WisdomKasozi/project-apogee/build-photos/hardware-store-materials-and-paint.webp

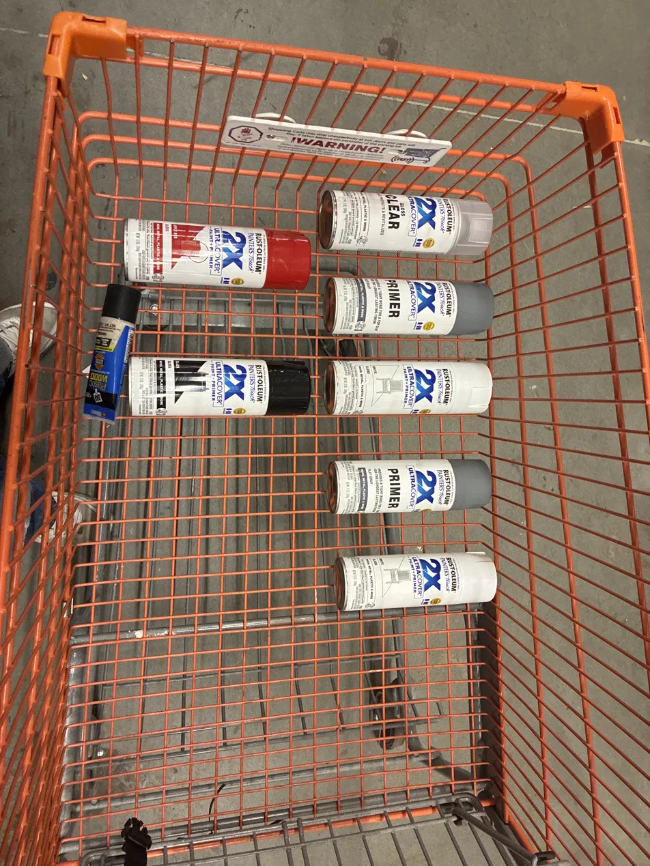
build-photos/hardware-store-materials-and-paint.webp
