WisdomKasozi/project-apogee/build-photos/balsa-fin-cutting-blueprint.webp

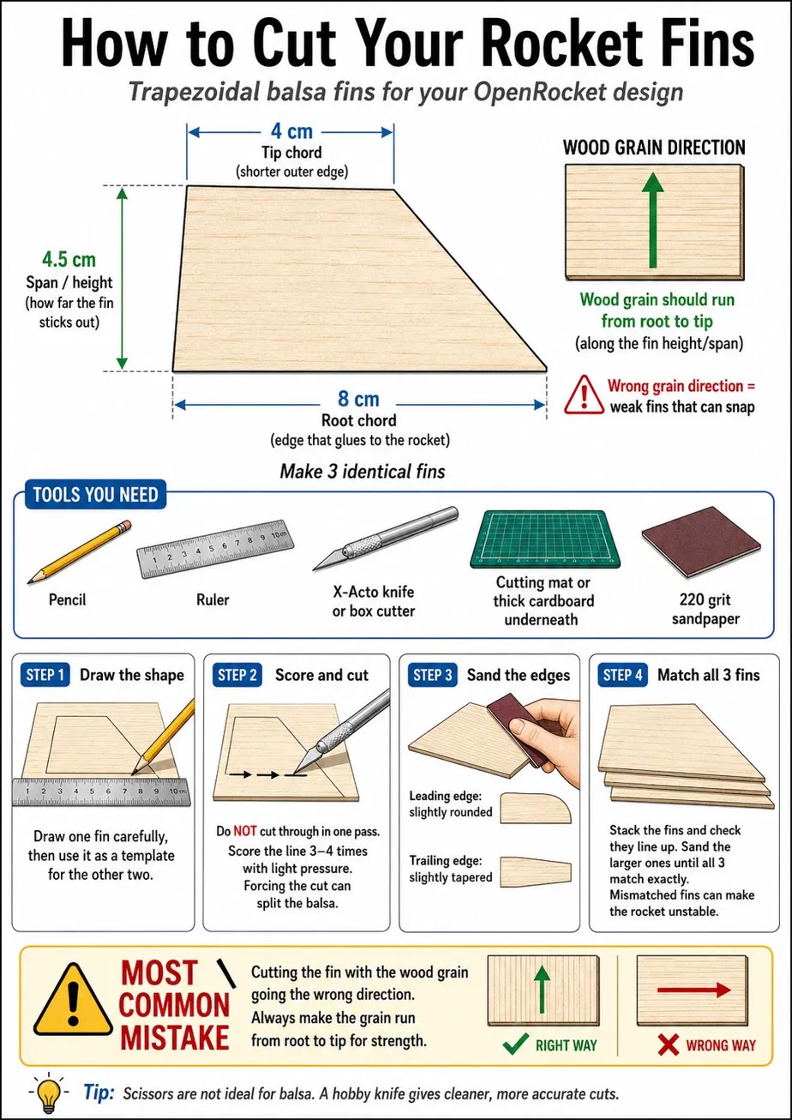
build-photos/balsa-fin-cutting-blueprint.webp
