WisdomKasozi/project-apogee/flight/graphs/graph1_altitude_profile.png

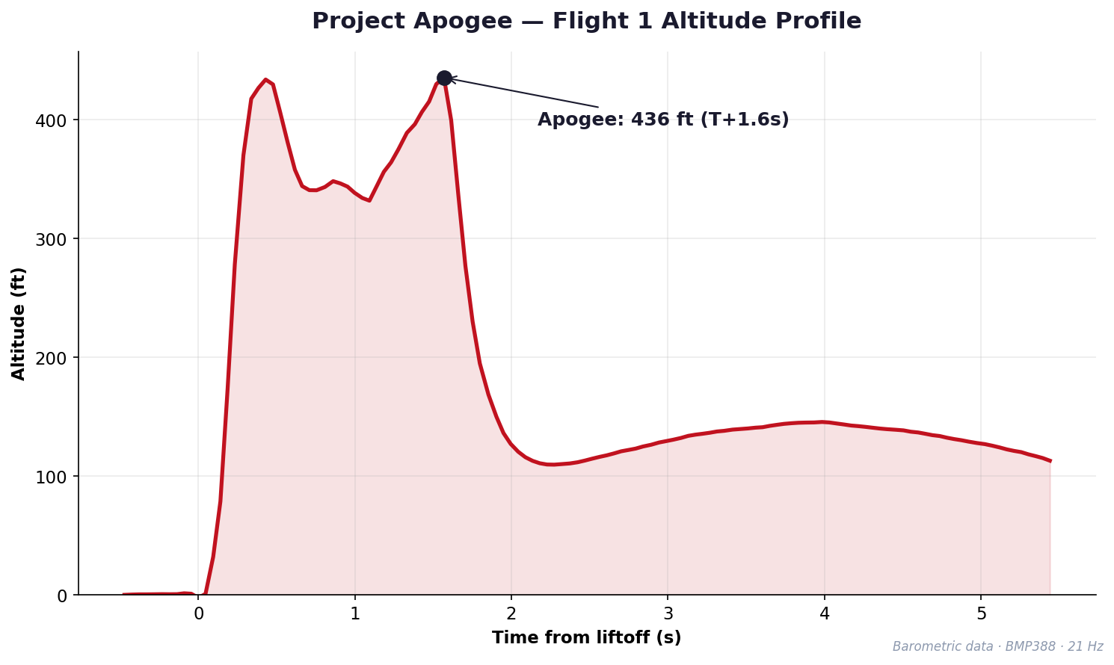
flight/graphs/graph1_altitude_profile.png
