WisdomKasozi/project-apogee/flight/graphs/graph2_acceleration_profile.png

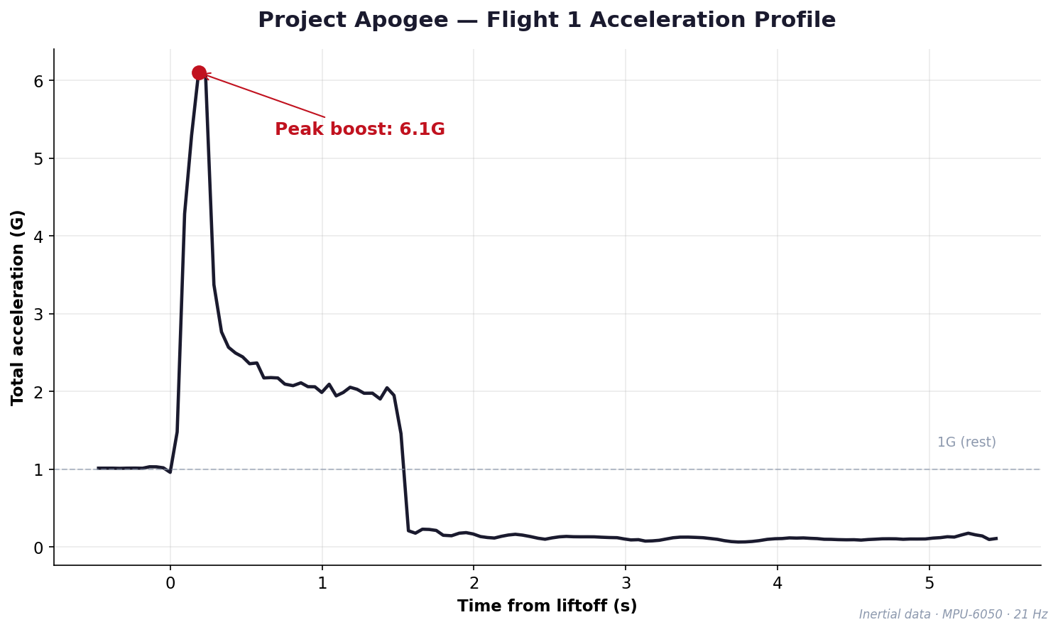
flight/graphs/graph2_acceleration_profile.png
