WisdomKasozi/project-apogee/flight/graphs/graph3_sim_vs_actual.png

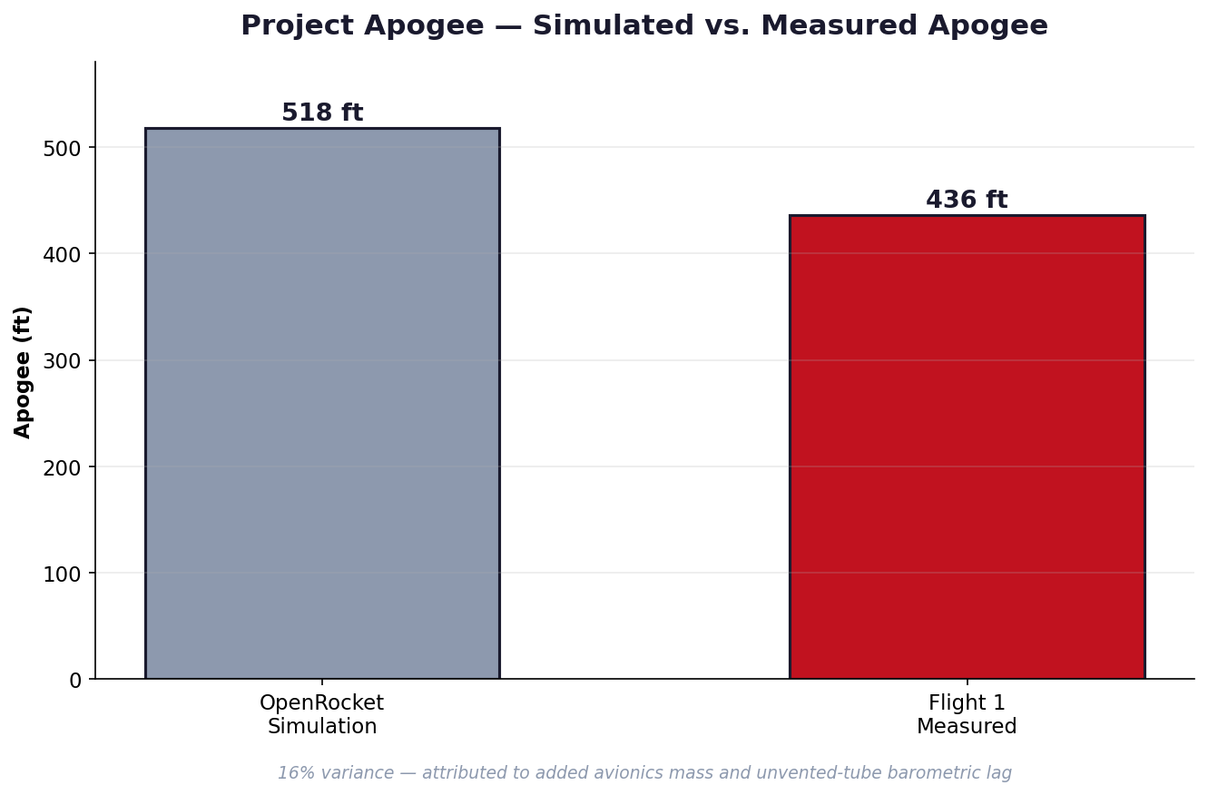
flight/graphs/graph3_sim_vs_actual.png
