WisdomKasozi/project-apogee/simulation/as-built/as-built-plot.png

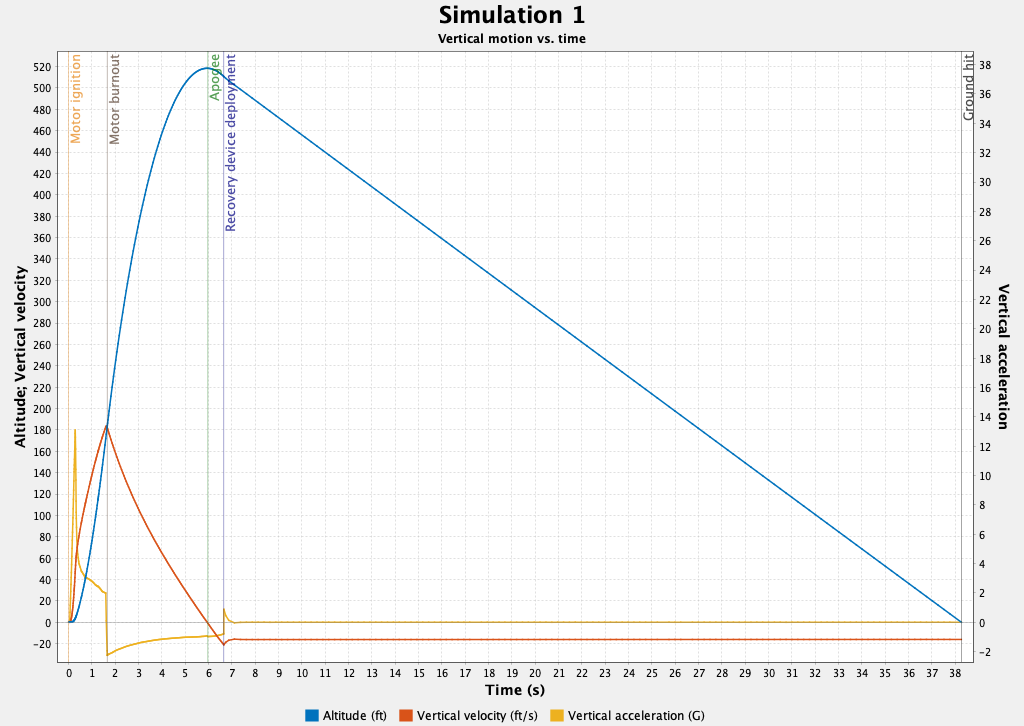
simulation/as-built/as-built-plot.png
