WisdomKasozi/project-apogee/simulation/pre-build/notes.md

## Pre-Build Simulation Notes

Date: May 2026

This simulation was completed before the parts arrived.
Dimensions are based on standard BT-60 specs and planned 
component dimensions. Weights are estimated.

### Key Results
- Stability margin: 1.64 calibers
- Apogee: 586 ft
- Velocity off rod: 61.4 ft/s (42 mph)
- Motor: Estes D12-5
- No warnings

### What changes in the built simulation
- Actual measured component weights
- Confirmed nose cone length
- Confirmed body tube cut lengths
- Electronics mass object added with real weight

## Simulation
OG sim
