WisdomKasozi/project-apogee/build-photos/assembled-airframe-and-nosecone.png

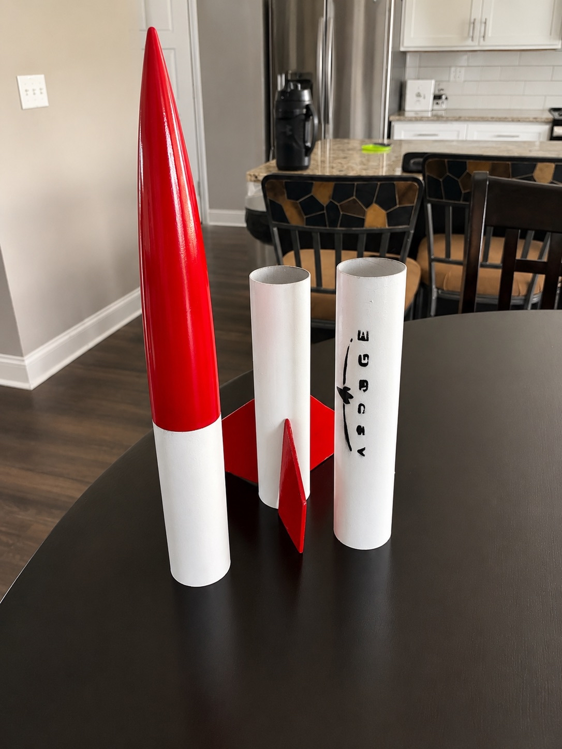
build-photos/assembled-airframe-and-nosecone.png
