WisdomKasozi/project-apogee/build-photos/motor-mount-and-launch-lug.webp

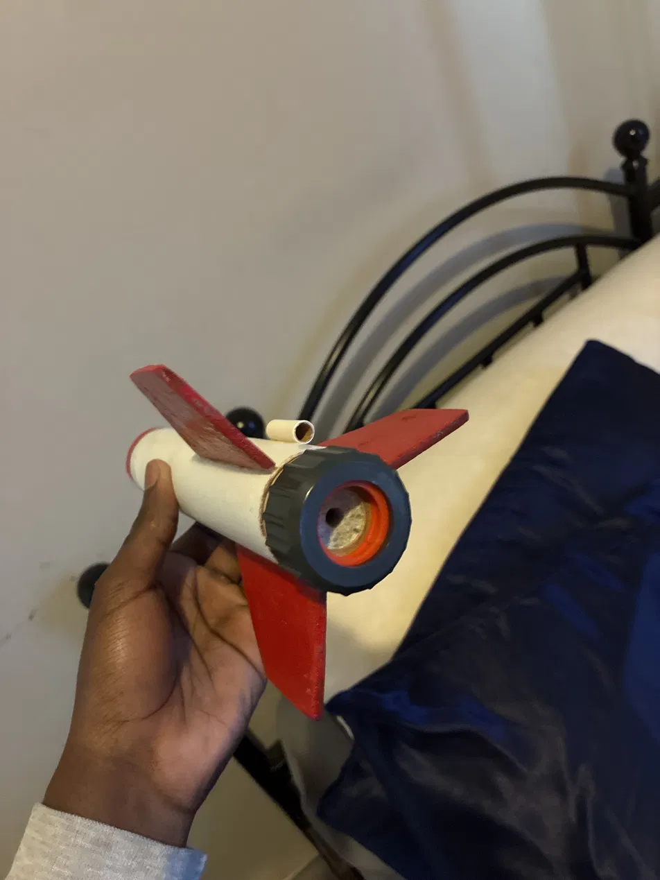
build-photos/motor-mount-and-launch-lug.webp
