WisdomKasozi/project-apogee/simulation/pre-build/Rocket Plot.png

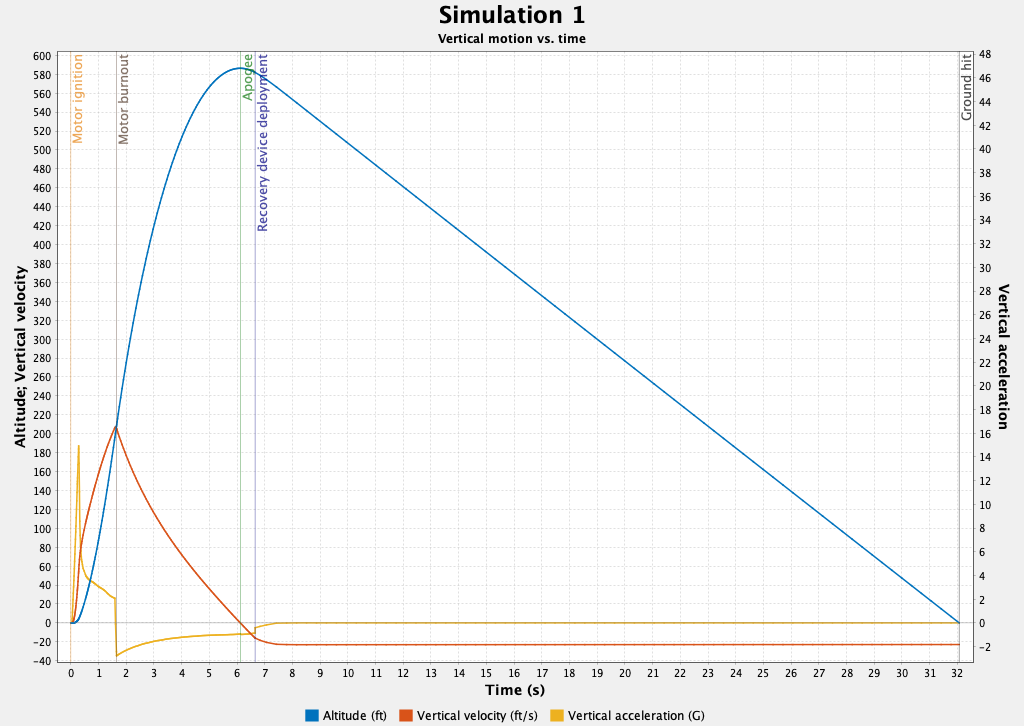
simulation/pre-build/Rocket Plot.png
