WisdomKasozi/project-apogee/(commit log)

2026-08-04 Add README for Project Apogee flight computer
    Added README.md to document Project Apogee flight computer firmware, including hardware, wiring, functionality, and libraries used.
2026-08-04 Update README with flight data explanation
    Clarified reasons for discrepancies between simulation and actual flight data, including weight and pressure lag factors.
